Utilitron-Robotics/johnny5/software/README.md

This folder includes AlohaMini-specific patches and extensions for the LeRobot framework.

If you prefer a plug-and-play setup with all components already integrated,
please use the dedicated software repository:

👉 https://github.com/liyitenga/lerobot_alohamini
