Utilitron-Robotics/johnny5/hardware/arms/README.md

This arm design is based on Lekiwi (base) and SO100 (arm structure).
We merged and adapted the two projects for the AlohaMini platform.
Huge thanks to the original creators for their excellent work.

Original projects:

- Lekiwi: https://github.com/SIGRobotics-UIUC/LeKiwi

- SO100: https://github.com/TheRobotStudio/SO-ARM100
