Utilitron-Robotics/johnny5/docs/integration_review.md

# Integration Review: Johnny 5 + WhoAmI

## 1. Overview
We have successfully forked the original AlohaMini/LeKiwi codebase and transformed it into **Johnny 5**, a Tier-3 autonomous mobile manipulator. This review covers the integration of the "WhoAmI" intelligence stack (derived from `alanchelmickjr/whoami`) into the new Johnny 5 architecture.

## 2. The "WhoAmI" Intelligence Stack
We successfully recovered and ported the following core components from the "LetsConnect" repository:

### 🧠 Memory (Gun.js)
*   **Source**: `whoami/gun_storage.py` -> `johnny5/memory.py`
*   **Function**: Provides decentralized, encrypted, graph-based storage for the robot's experiences.
*   **Key Feature**: "Robot-owned data" philosophy. Faces and interactions are stored locally and encrypted, respecting user privacy while enabling long-term memory.

### 🗣️ Voice (PyTTSx3 + Vosk/Google)
*   **Source**: `whoami/voice_interaction.py` -> `johnny5/voice.py`
*   **Function**: Enables natural language interaction.
*   **Key Feature**: The `ask_name()` flow allows the robot to proactively build its social graph by asking strangers for their names and confirming them.

### 👁️ Vision (Face Recognition)
*   **Source**: `whoami/face_recognition_api.py` -> `johnny5/vision.py`
*   **Function**: Detects and identifies people.
*   **Key Feature**: Integrated with the Memory system to link visual embeddings with "Person" nodes in the Gun.js graph.

## 3. LeRobot Integration Strategy
The `Johnny5Robot` class (`software/src/johnny5/robot.py`) has been re-architected to serve as a **LeRobot-compatible Agent**.

*   **Observation Space**:
    *   `observation.images.camera_front`: RGB feed from OAK-D/RealSense.
    *   `observation.state`: Joint positions (arms) + Base velocity.
*   **Action Space**:
    *   `action`: 14-DOF vector (Arm Joints + Base Velocity + Lift).
*   **Policy Loop**:
    *   The `step()` method enables the robot to run LeRobot inference (ACT/Diffusion policies) while simultaneously maintaining a social presence via the "WhoAmI" background threads.

## 4. Next Steps
1.  **Hardware Drivers**: Implement the `DifferentialDrive` class for the specific off-the-shelf base chosen.
2.  **Policy Training**: Collect teleoperation data using the new rig to train a `johnny5-manipulation` policy.
3.  **ROS 2 Bridge**: (Optional) Wrap the Python `Johnny5Robot` class in a ROS 2 Node for easier integration with the Nav2 stack.
