Utilitron-Robotics/johnny5/docs/BOM.md

# Bill of Materials

AlohaMini follows the same architecture and terminology as LeKiwi, consisting of a Client side and a Host side.

- The Client handles computation and control.
- The Host executes commands and returns observations.

This is also commonly referred to as PC side vs. Remote side, and both naming conventions are equivalent.

AlohaMini’s Client hardware includes the mobile base and two follower arms. The arms directly reuse the SO-ARM100 design. Therefore, if you already have two SO-ARM100 arms, you only need to assemble the mobile base. Communication between the mobile base, arms, and Raspberry Pi 5 uses the same bus-servo communication system, and the build guide will explain the wiring in detail.

On AlohaMini, the Host side consists of a PC workstation and leader arms. VR controllers or other devices can also replace the leader arms, and we will release compatible controller kits soon. For beginners, we recommend starting with leader-arm teleoperation.

*Note: Table clamp, screwdriver set, soldering iron, and other common tools can be sourced as needed and are not listed in the tables below.*

## Mobile base 

| Item | Model / Notes | Qty | Unit Cost (US) | Buy (US) | Unit Cost (CN) | Buy (CN) |
|---|---|-----|---|---|---|---|
| Servo motor | Feetech STS3215 (12 V bus) | 4 | $13.89 | [Alibaba](https://www.alibaba.com/product-detail/6PCS-7-4V-STS3215-Servos-for_1600523509006.html) | ¥110 | [taobao](https://e.tb.cn/h.64H9u3maGWzIp5Q?tk=T5liexkG6Yz) |
| Omni wheel | 4″ (≈100 mm) | 3 | $47 | [Amazon](https://www.amazon.com/Replacement-Plastic-Directional-Accessories-Platform/dp/B0F9W6QX5M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) | ¥135 | [pinduoduo](https://mobile.yangkeduo.com/goods.html?ps=kKWPC7xuzw) |
| USB camera | 720p focal length 2.4 mm | 3 | — | Amazon | ¥125 | [taobao](https://item.taobao.com/item.htm?id=666278411821) |
| (optional) Bearing | 12×18×4 mm (ID × OD × W) — wheel axle bearing | 3 | — | Amazon | ¥6 | [tmall](https://detail.tmall.com/item.htm?id=824704356695) |
| Bearing | 4×13×5 mm (ID × OD × W) — lift axis bearing | 8 | — | Amazon | ¥3 | [taobao](https://item.taobao.com/item.htm?id=565418362178) |
| M2×12 Phillips screw | For camera mounts (OB_T_Camera_Mount.stl, OB_Top_Camera_Mount) | 12 | — | — | — | — |
| M3×12 hex socket screw | Total 36 pcs (Servo Mount×24 ,Side Panel×12 ) | 36 | — | — | — | — |
| M3×18 hex socket screw | For OB_Chassis_Wheel_Axle_Connector.stl | 12 | — | — | — | — |
| M3×30 hex socket screw | For OB_T_Connector_Right/Left.stl | 8 | — | — | — | — |
| M3 hex nut | For OB_T_Connector_Right/Left.stl | 8 | — | — | — | — |
| M3x5x4 heat-set insert | Total 36 pcs (Servo Mount×24, Side Panel×12) | 36 | — | Amazon | ¥5 | [taobao](https://item.taobao.com/item.htm?id=809241671998) |
| M4×12 hex socket screw | Total 20 pcs (Bearing Cover×12, Z-axis Servo Mount×8) | 20 | — | Amazon | — | — |
| M4x6x5 heat-set insert | For OB_Chassis_Bearing_Cover.stl | 12 | — | Amazon | ¥4 | [taobao](https://item.taobao.com/item.htm?id=809241671998) |
| Adhesive | Double-sided tape / epoxy — cable retention & structural bonding | 1 | — | Amazon | ¥12 | [jd](https://item.jd.com/100141557259.html) |
| Servo extension cable | SCS 3-pin, 90 cm | 2 | — | Amazon | ¥3 | [taobao](https://item.taobao.com/item.htm?id=616460581906) |
| Battery | 12V Li-ion pack with 5521 barrel jack (male & female) | 1 | $43 | [Amazon](https://www.amazon.com/KBT-Rechargeable-Connector-Replacement-Security/dp/B0C242DYT1/ref=sr_1_2_sspa?th=1) | ¥130 | [taobao](https://item.taobao.com/item.htm?id=890828103056) |
| USB Type-C cable | Only for testing the mobile base | 1 | $10 | [Amazon](https://www.amazon.com/Charging-etguuds-Charger-Braided-Compatible/dp/B0B8NWLLW2/?th=1) | ¥20 | [tmall](https://detail.tmall.com/item.htm?id=754024805047) |
| Waveshare Bus Servo Controller | Only for testing the mobile base | 1 | $13 | [Amazon](https://www.amazon.com/Waveshare-Integrates-Control-Circuit-Supports/dp/B0CTMM4LWK/) | ¥27 | [tmall](https://detail.tmall.com/item.htm?id=738817173460) |
| 3D-printed parts | PLA/PETG/ABS (files in /hardware/mobile_base/stl) | ~4 kg filament | — | — | — | — |

**3D Printing Parts List:**
- OB_Chassis_Bearing_Cover x3
- OB_Chassis_Servo_Mount x3
- OB_Chassis_Side_Panel x3
- OB_Chassis_Wheel_Axle_Connector x3
- OB_Chassis_Wheel_Guard x3
- All other files x1

### What the Base Can Do

With only the components above, you can assemble the **mobile base** and control:

- movement  
- vertical lift  

directly from your **PC**, without installing a single-board computer on the robot.

We will cover the specifics in the software setup section.

Effect after assembly:

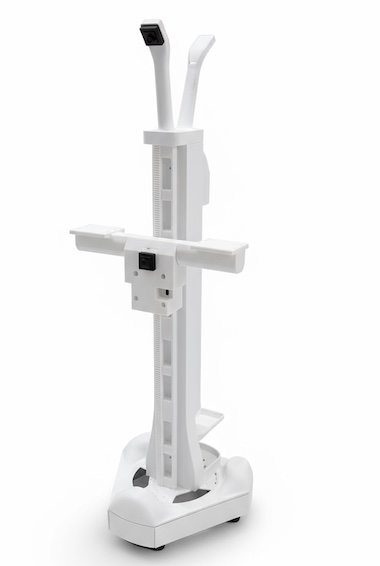
[picture p5: docs/media/assembled.jpg]
Assembled AlohaMini mobile base

### Standalone Mode (Optional)

If you prefer the base to operate as an **independent host system** (Wi‑Fi, untethered), add:

| Item | Model / Notes | Qty | Unit Cost (US) | Buy (US) | Unit Cost (CN) | Buy (CN) |
|---|---|-----|---|---|---|---|
| Compute board | Raspberry Pi 5 (4GB/8GB) | 1 | — | [Adafruit](https://www.adafruit.com/product/5812) | ¥600 | [taobao](https://item.taobao.com/item.htm?id=688878446695) |
| DC converter | 12V → 5V / 5A buck converter | 1 | $13 | [Amazon](https://www.amazon.com/Klnuoxj-Converter-Interface-Waterproof-Compatible/dp/B0CRVW7N2J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) | ¥64 | [taobao](https://item.taobao.com/item.htm?id=800698078303) |
| Monitor | 7-inch HD IPS HDMI interface + touch + Type C power supply | 1 | — | Amazon | ¥291 | [taobao](https://item.taobao.com/item.htm?id=592070943040) |

## Follower Arms
| Item | Model / Notes | Qty | Unit Cost (US) | Buy (US) | Unit Cost (CN) | Buy (CN) |
|---|---|-----|---|---|---|---|
| Servo motor | Feetech STS3215 (12V bus) | 12 | $13.89 | [Alibaba](https://www.alibaba.com/product-detail/Feetech-STS3215-SO-ARM100-Servo-12V_1601292634404.html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) | ¥110 | [taobao](https://e.tb.cn/h.64H9u3maGWzIp5Q?tk=T5liexkG6Yz) |
| Waveshare Bus Servo Controller | For connecting to the Raspberry Pi 5 | 2 | $13 | [Amazon](amazon.com/Waveshare-Integrates-Control-Circuit-Supports/dp/B0CTMM4LWK/) | ¥27 | [tmall](https://detail.tmall.com/item.htm?id=738817173460) |
| USB camera | 720p focal length 3.8 mm | 2 | — | Amazon | ¥103 | [taobao](https://item.taobao.com/item.htm?id=590682120464) |
| Battery | 12V Li-ion pack | 1 | — | [Amazon](https://www.amazon.com/KBT-Rechargeable-Connector-Replacement-Security/dp/B0C242DYT1/ref=sr_1_2_sspa?th=1) | ¥130 | [taobao](https://item.taobao.com/item.htm?id=890828103056) |
| 1-to-2 DC splitter cable | 30 cm, 5521 connector — for powering the arms | 1 | — | Amazon | ¥5 | [taobao](https://item.taobao.com/item.htm?id=594921965049) |
| DC extension cable | 1.5 m, 5521 connector — for powering the arms | 2 | — | Amazon | ¥2.50 | [taobao](https://item.taobao.com/item.htm?id=43628177900) |
| USB Type-C cable | For connecting to the Raspberry Pi 5 | 2 | $10 | [Amazon](https://www.amazon.com/Charging-etguuds-Charger-Braided-Compatible/dp/B0B8NWLLW2/?th=1) | ¥20 | [tmall](https://detail.tmall.com/item.htm?id=754024805047) |
| 3D-printed parts | PLA/PETG/ABS (files in /hardware/arms/stl) | 1 set | — | — | — | — |

**3D Printing Parts List:**
- All "D_*.stl" files: x2
- All "F_*.stl" files: x2

For detailed printing instructions, refer to the [SO-ARM100 project README](https://github.com/TheRobotStudio/SO-ARM100)

## Leader Arms
> **Note:** The official SO-ARM100 design uses three different gear ratios (1/147, 1/191, 1/345) for optimal performance. However, our testing shows that using a single gear ratio (1/147) provides excellent user experience and significantly simplifies assembly. The BOM below reflects this simplified configuration.

| Item | Model / Notes | Qty | Unit Cost (US) | Buy (US) | Unit Cost (CN) | Buy (CN) |
|---|---|-----|---|---|---|---|
| Servo motor | Feetech STS3215 (7.4V bus, 147:1 gear ratio) | 12 | $13.89 | [Alibaba](https://www.alibaba.com/product-detail/Standard-Open-SO-100-SO-101_1601503860487.html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) | ¥99 | [taobao](https://item.taobao.com/item.htm?id=616159163206) |
| Waveshare Bus Servo Controller | For connecting to the PC | 2 | $13 | [Amazon](https://www.amazon.com/Waveshare-Integrates-Control-Circuit-Supports/dp/B0CTMM4LWK/) | ¥27 | [tmall](https://detail.tmall.com/item.htm?id=738817173460) |
| Battery | 5V Li-ion pack | 1 | — | Amazon | ¥30 | [taobao](https://item.taobao.com/item.htm?id=765749120668) |
| 1-to-2 DC splitter cable | 70 cm — for powering the arms | 1 | — | Amazon | ¥5 | [taobao](https://item.taobao.com/item.htm?id=594921965049) |
| USB Type-C cable | For connecting to the PC | 2 | $10 | [Amazon](https://www.amazon.com/Charging-etguuds-Charger-Braided-Compatible/dp/B0B8NWLLW2/?th=1) | ¥20 | [tmall](https://detail.tmall.com/item.htm?id=754024805047) |
| 3D-printed parts | PLA/PETG/ABS (files in /hardware/arms/stl) | 1 set | — | — | — | — |

**3D Printing Parts List:**
- All "D_*.stl" files: x2
- All "L_*.stl" files: x2

For detailed printing instructions, refer to the [SO-ARM100 project README](https://github.com/TheRobotStudio/SO-ARM100)
