Utilitron-Robotics/johnny5/hardware/alohamini_base/stl/O_Main_Assembly_Post1.stl

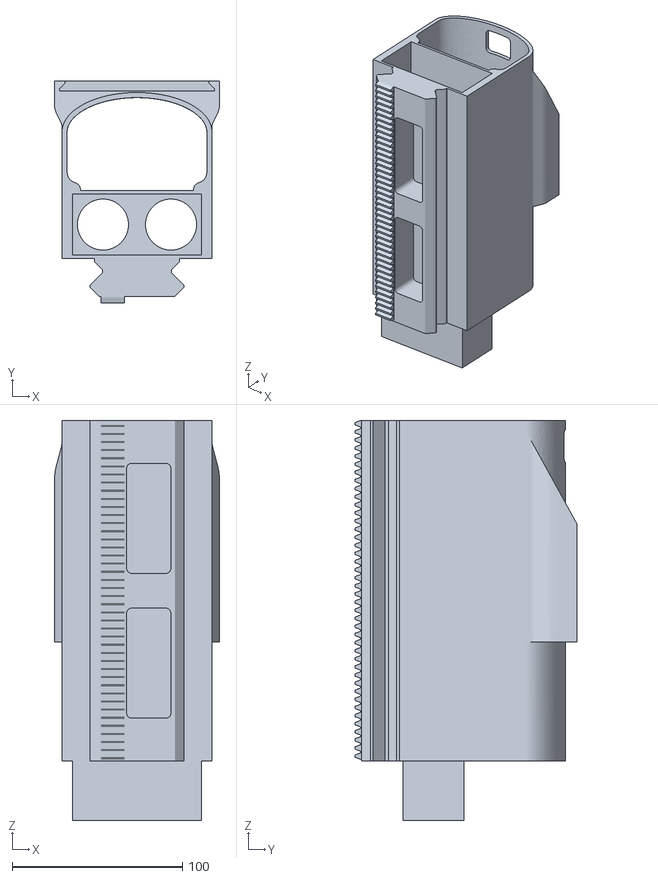
[picture p6: CAD file, 2025-11-22]
hardware/alohamini_base/stl/O_Main_Assembly_Post1.stl
97.0 x 130.7 x 235.0
