Utilitron-Robotics/johnny5/hardware/alohamini_base/stl/O_Main_Assembly_Post3.stl

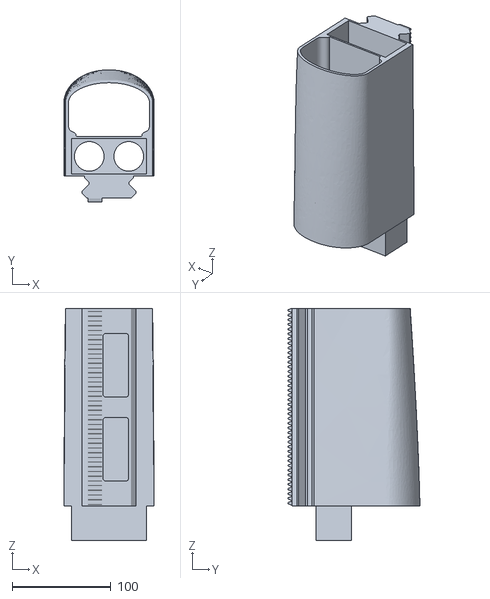
[picture p7: CAD file, 2025-11-22]
hardware/alohamini_base/stl/O_Main_Assembly_Post3.stl
91.5 x 133.6 x 235.0
