Utilitron-Robotics/johnny5/hardware/alohamini_base/stl/O_Main_Assembly_Post2.stl

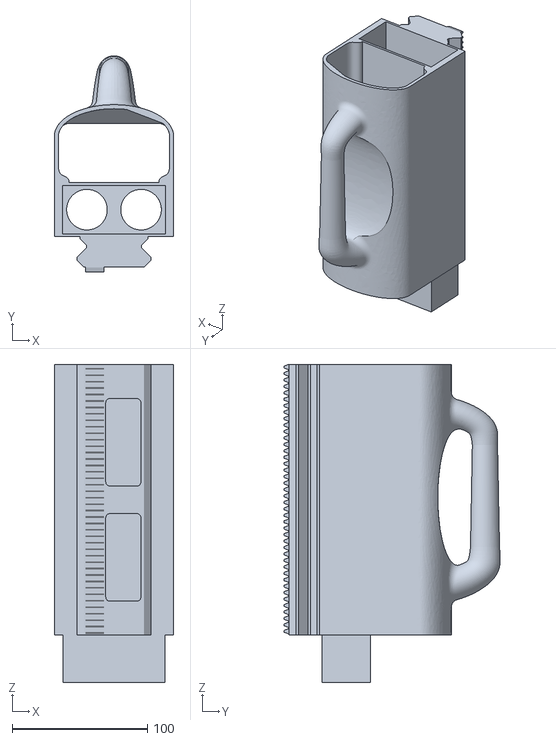
[picture p8: CAD file, 2025-11-22]
hardware/alohamini_base/stl/O_Main_Assembly_Post2.stl
88.1 x 159.9 x 235.0
