Utilitron-Robotics/johnny5/hardware/alohamini_base/stl/OB_Main_Monitor_Connector.stl

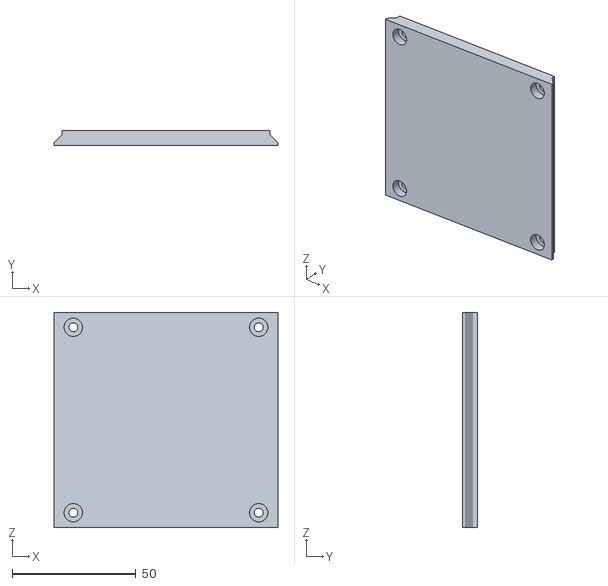
[picture p9: CAD file, 2025-11-22]
hardware/alohamini_base/stl/OB_Main_Monitor_Connector.stl
90.6 x 6.00 x 87.0
