Utilitron-Robotics/johnny5/hardware/alohamini_base/stl/OB_Top_Camera_Back_Cover.stl

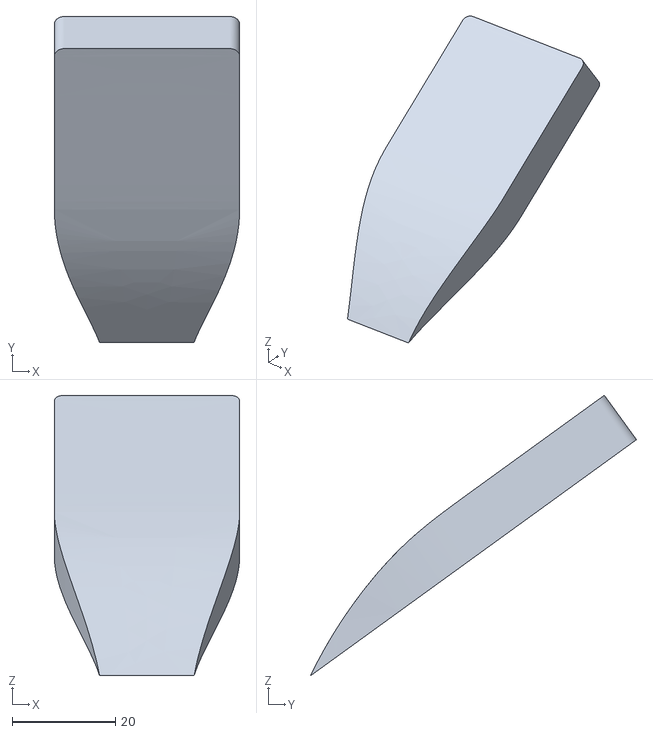
[picture p10: CAD file, 2025-11-22]
hardware/alohamini_base/stl/OB_Top_Camera_Back_Cover.stl
35.9 x 63.2 x 54.4
