Utilitron-Robotics/johnny5/hardware/alohamini_base/stl/Optional/OB_Chassis_Shaft_Sleeve_12_24.stl

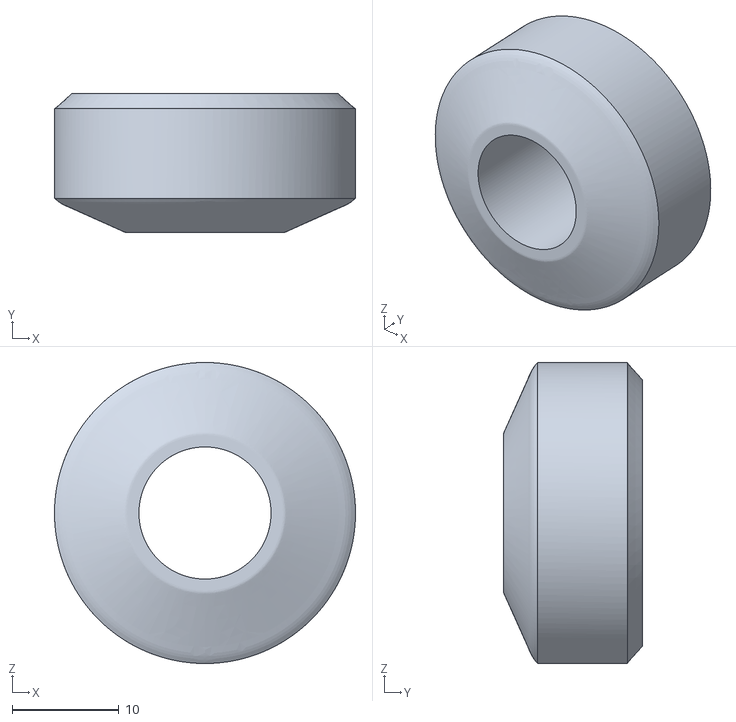
[picture p11: CAD file, 2025-11-22]
hardware/alohamini_base/stl/Optional/OB_Chassis_Shaft_Sleeve_12_24.stl
28.1 x 13.0 x 28.1
