Utilitron-Robotics/johnny5/hardware/arms/stl/D_Motor_holder_SO101_Wrist.stl

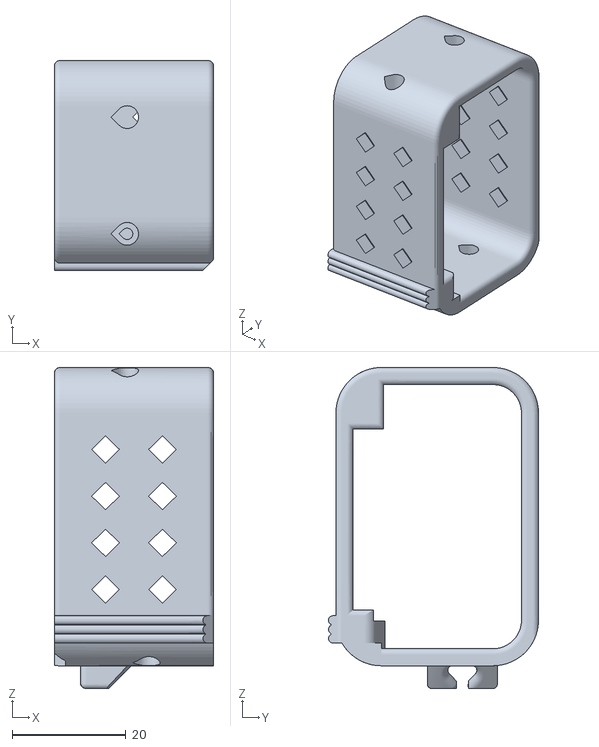
[picture p12: CAD file, 2025-11-22]
hardware/arms/stl/D_Motor_holder_SO101_Wrist.stl
28.0 x 36.9 x 56.4
