Utilitron-Robotics/johnny5/hardware/alohamini_base/stl/O_Chassis_Lower_Plate.stl

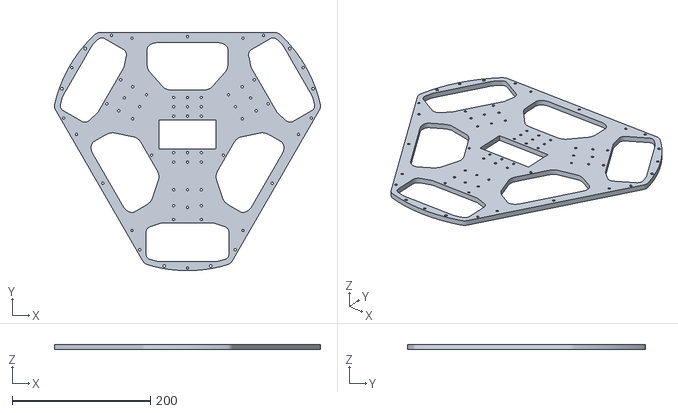
[picture p13: CAD file, 2025-11-22]
hardware/alohamini_base/stl/O_Chassis_Lower_Plate.stl
384.5 x 344.4 x 7.00
