Utilitron-Robotics/johnny5/hardware/alohamini_base/stl/Optional/O_Chassis_Dowel_Pin_12_24.stl

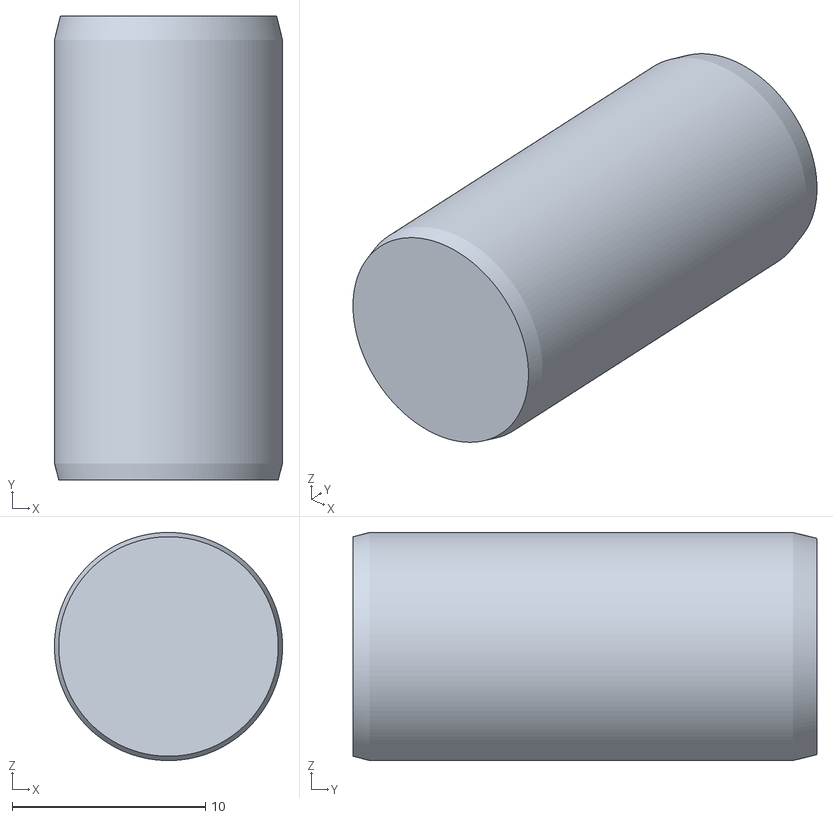
[picture p14: CAD file, 2025-11-22]
hardware/alohamini_base/stl/Optional/O_Chassis_Dowel_Pin_12_24.stl
11.8 x 24.0 x 11.8
