Utilitron-Robotics/johnny5/hardware/arms/stl/D_Seeedstudio_Mounting_Plate_SO101.stl

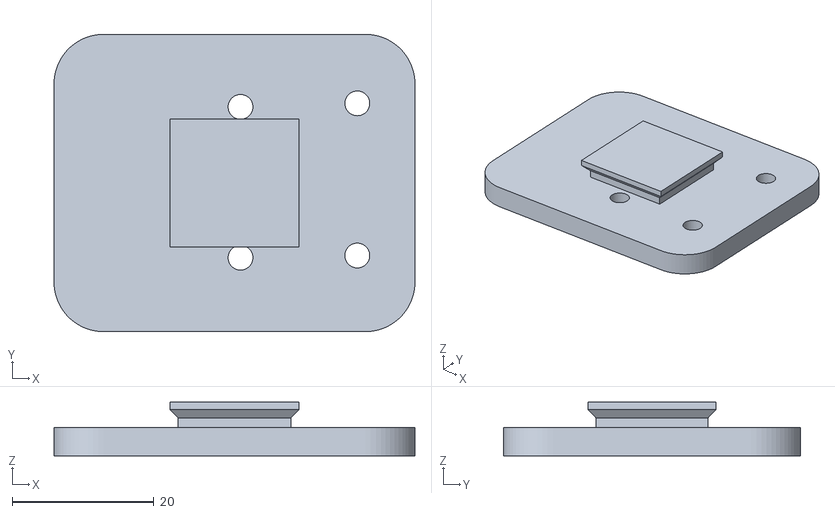
[picture p15: CAD file, 2025-11-22]
hardware/arms/stl/D_Seeedstudio_Mounting_Plate_SO101.stl
51.0 x 42.0 x 7.60
