Utilitron-Robotics/johnny5/hardware/alohamini_base/stl/OB_Chassis_Side_Panel.stl

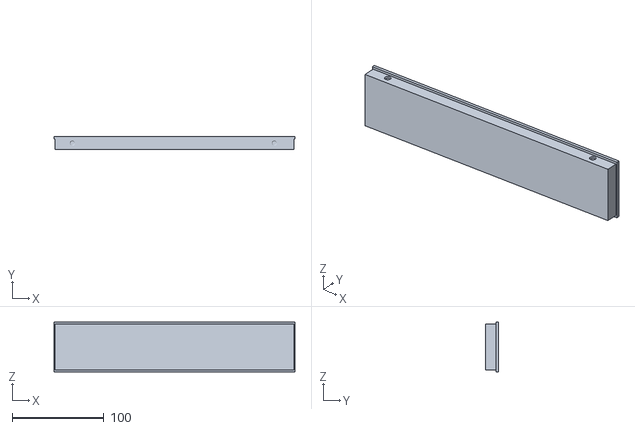
[picture p16: CAD file, 2025-11-22]
hardware/alohamini_base/stl/OB_Chassis_Side_Panel.stl
262.2 x 14.0 x 54.2
