Utilitron-Robotics/johnny5/hardware/arms/stl/D_Rotation_Pitch_SO101.stl

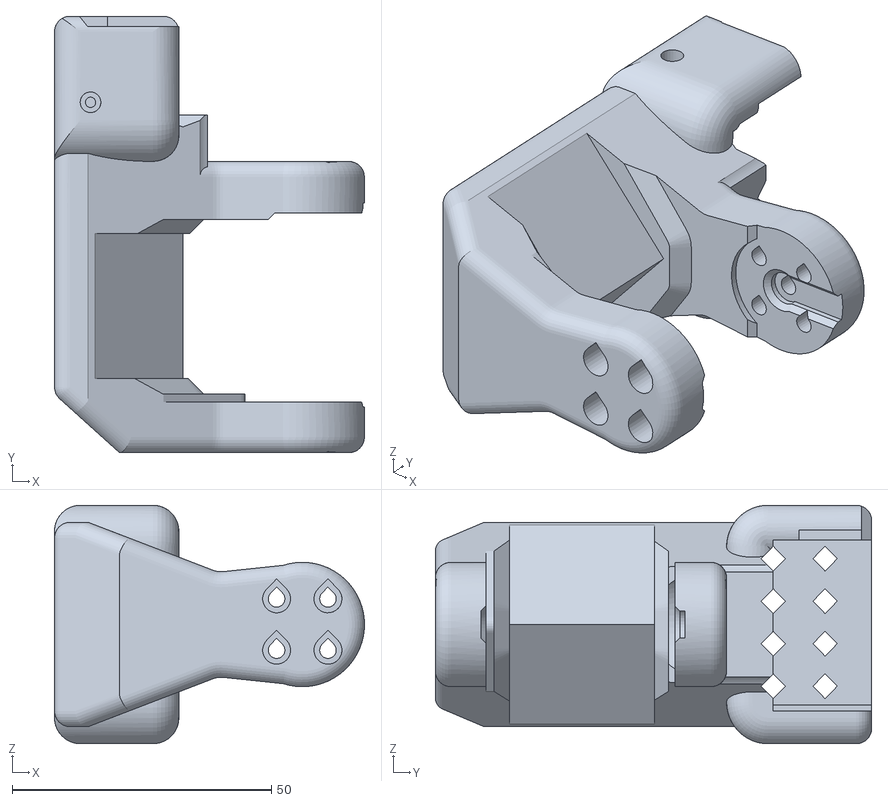
[picture p17: CAD file, 2025-11-22]
hardware/arms/stl/D_Rotation_Pitch_SO101.stl
59.8 x 84.2 x 46.0
