Utilitron-Robotics/johnny5/hardware/alohamini_base/stl/OB_Z_Axis_Servo_Mount.stl

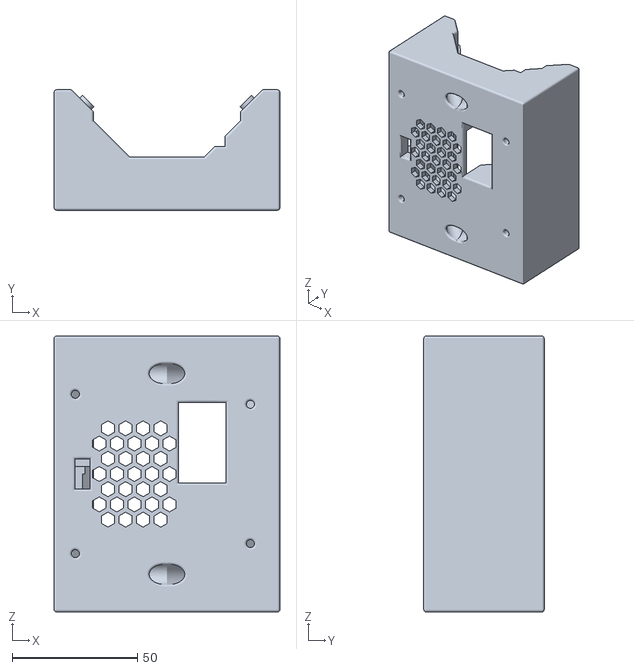
[picture p18: CAD file, 2025-11-22]
hardware/alohamini_base/stl/OB_Z_Axis_Servo_Mount.stl
90.0 x 48.0 x 110.0
