Utilitron-Robotics/johnny5/hardware/arms/stl/D_Under_arm_SO101.stl

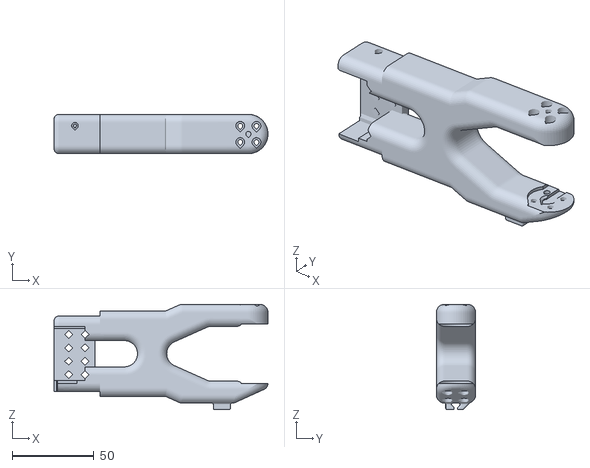
[picture p20: CAD file, 2025-11-22]
hardware/arms/stl/D_Under_arm_SO101.stl
130.7 x 24.0 x 64.4
