Utilitron-Robotics/johnny5/hardware/arms/stl/D_Base_SO101_Lekiwi.stl

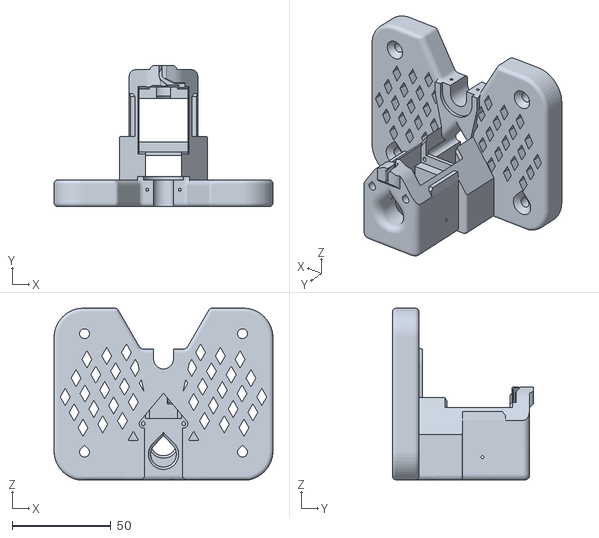
[picture p21: CAD file, 2025-11-22]
hardware/arms/stl/D_Base_SO101_Lekiwi.stl
110.9 x 71.6 x 87.0
