Utilitron-Robotics/johnny5/hardware/alohamini_base/stl/OB_T_Connector_Middle.stl

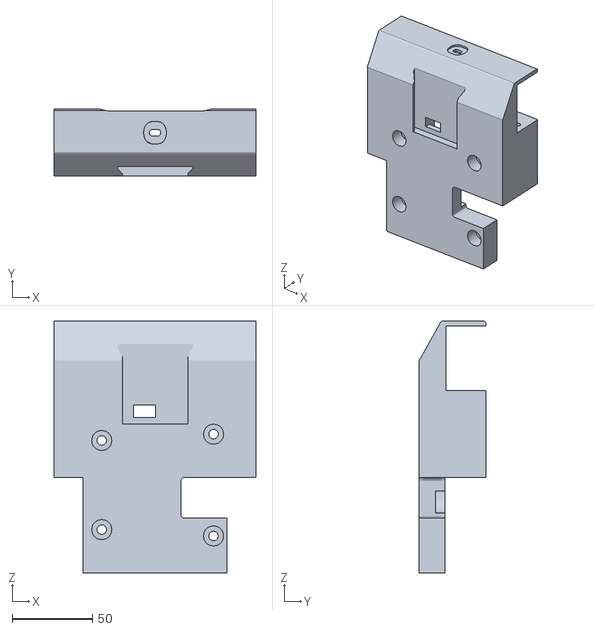
[picture p22: CAD file, 2025-11-22]
hardware/alohamini_base/stl/OB_T_Connector_Middle.stl
126.0 x 41.6 x 157.2
