Utilitron-Robotics/johnny5/hardware/arms/stl/L_Leader_Handle_SO101.stl

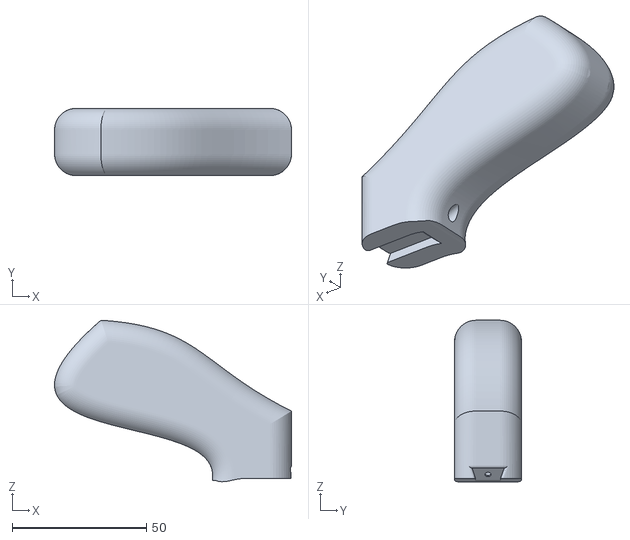
[picture p23: CAD file, 2025-11-22]
hardware/arms/stl/L_Leader_Handle_SO101.stl
88.1 x 25.0 x 60.1
