Utilitron-Robotics/johnny5/hardware/alohamini_base/stl/OB_T_Connector_Right.stl

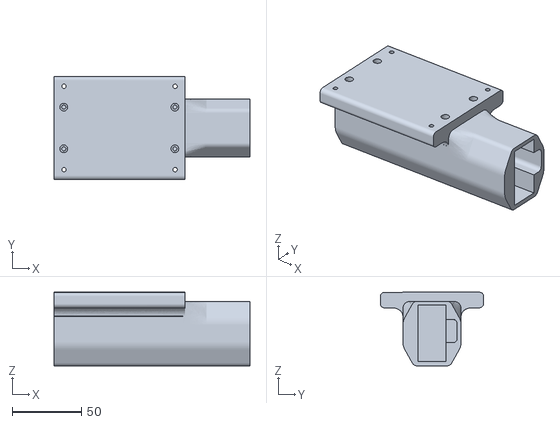
[picture p24: CAD file, 2025-11-22]
hardware/alohamini_base/stl/OB_T_Connector_Right.stl
141.1 x 74.4 x 53.1
