Utilitron-Robotics/johnny5/hardware/arms/stl/D_Wrist_Roll_Pitch_SO101.stl

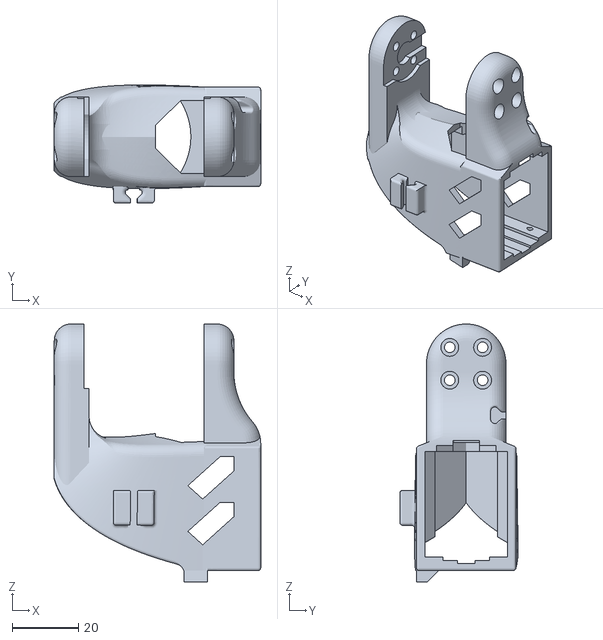
[picture p25: CAD file, 2025-11-22]
hardware/arms/stl/D_Wrist_Roll_Pitch_SO101.stl
62.3 x 35.7 x 77.8
