Utilitron-Robotics/johnny5/hardware/arms/stl/L_Leader_Trigger_SO101.stl

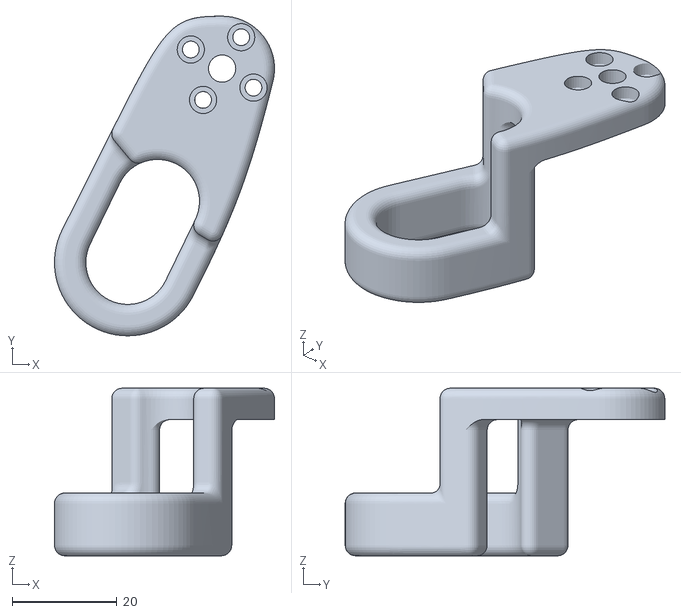
[picture p26: CAD file, 2025-11-22]
hardware/arms/stl/L_Leader_Trigger_SO101.stl
42.0 x 61.0 x 32.0
