Utilitron-Robotics/johnny5/hardware/alohamini_base/stl/OB_Chassis_Bearing_Cover.stl

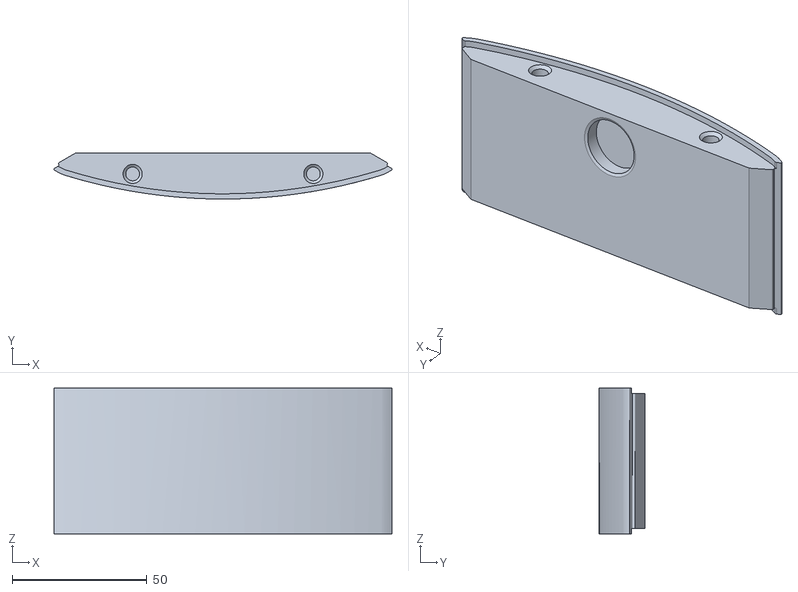
[picture p27: CAD file, 2025-11-22]
hardware/alohamini_base/stl/OB_Chassis_Bearing_Cover.stl
125.5 x 17.1 x 54.2
