Utilitron-Robotics/johnny5/hardware/arms/stl/D_Motor_holder_SO101_Base.stl

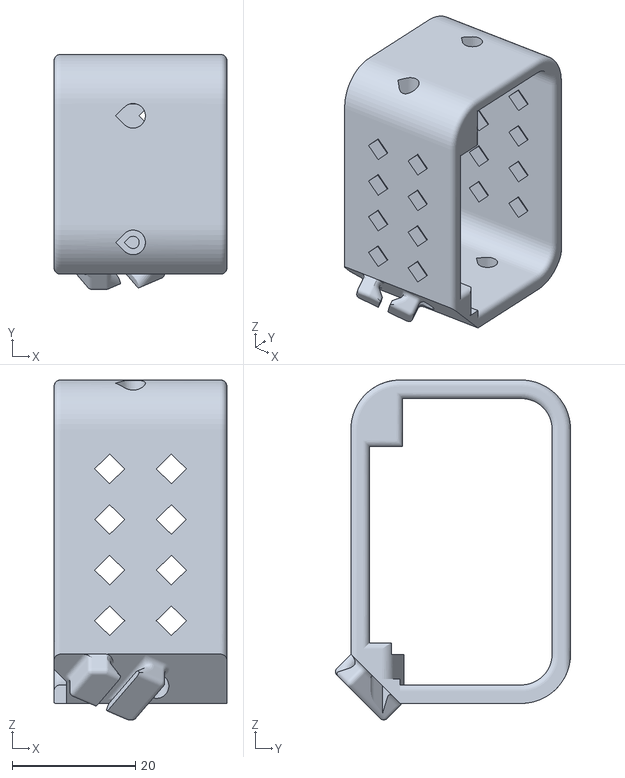
[picture p28: CAD file, 2025-11-22]
hardware/arms/stl/D_Motor_holder_SO101_Base.stl
28.0 x 38.1 x 55.1
