Utilitron-Robotics/johnny5/hardware/alohamini_base/stl/OB_T_Camera_Mount.stl

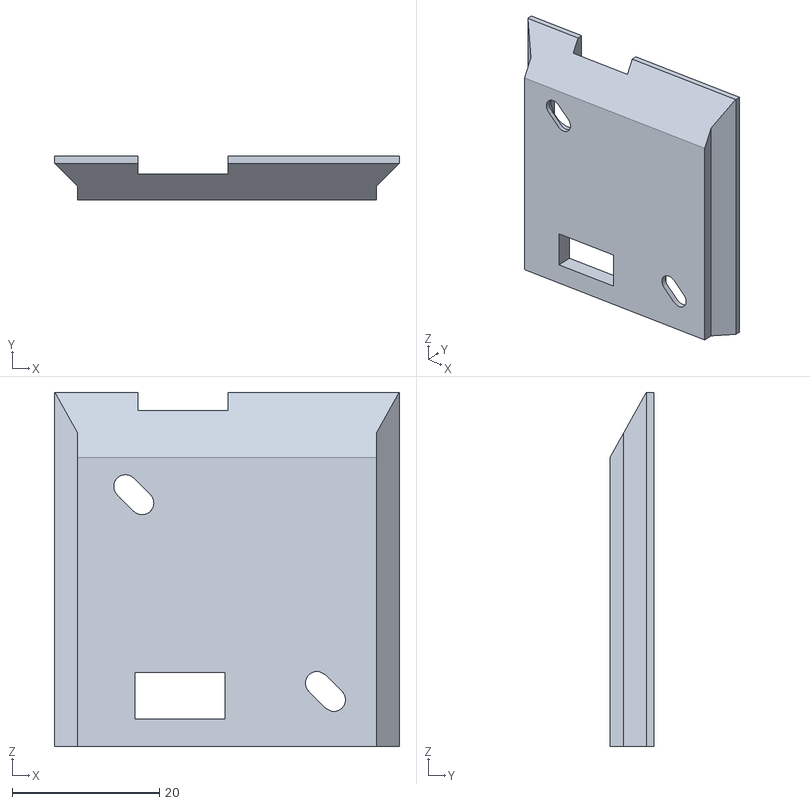
[picture p29: CAD file, 2025-11-22]
hardware/alohamini_base/stl/OB_T_Camera_Mount.stl
46.9 x 6.00 x 48.2
