Utilitron-Robotics/johnny5/hardware/arms/stl/F_Follower_Wrist_Roll_Follower_SO101.stl

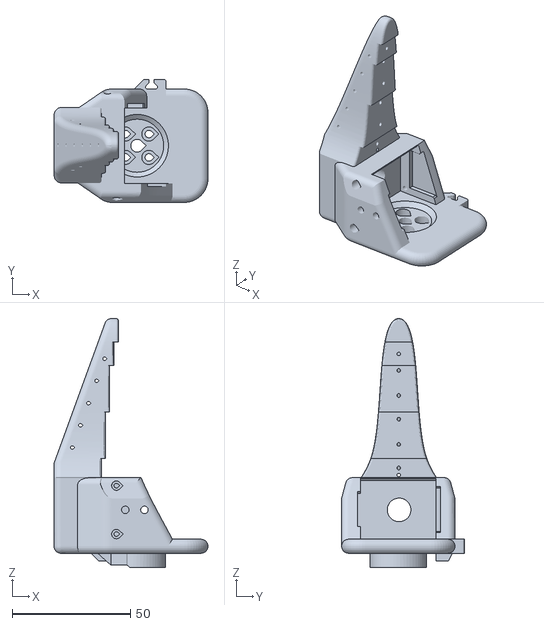
[picture p30: CAD file, 2025-11-22]
hardware/arms/stl/F_Follower_Wrist_Roll_Follower_SO101.stl
65.2 x 52.0 x 105.4
