Utilitron-Robotics/johnny5/hardware/arms/stl/D_Base_motor_holder_SO101.stl

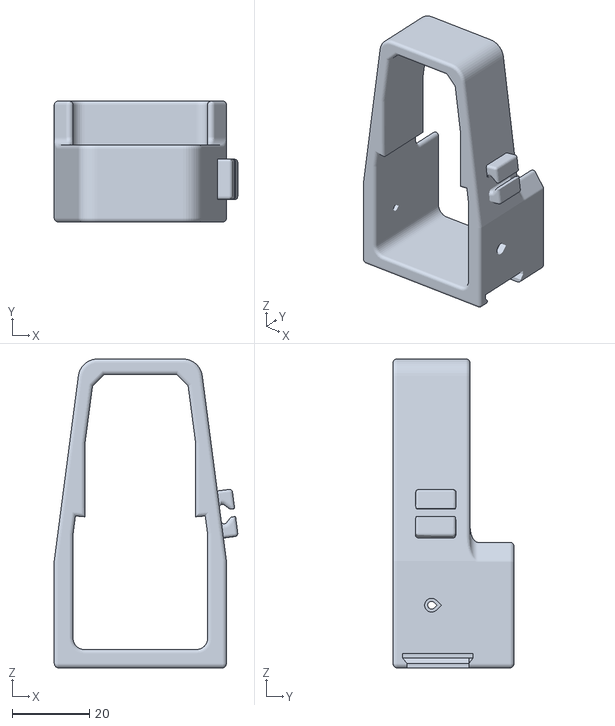
[picture p31: CAD file, 2025-11-22]
hardware/arms/stl/D_Base_motor_holder_SO101.stl
47.6 x 31.4 x 80.2
