Utilitron-Robotics/johnny5/hardware/alohamini_base/stl/OB_Chassis_Wheel_Axle_Connector.stl

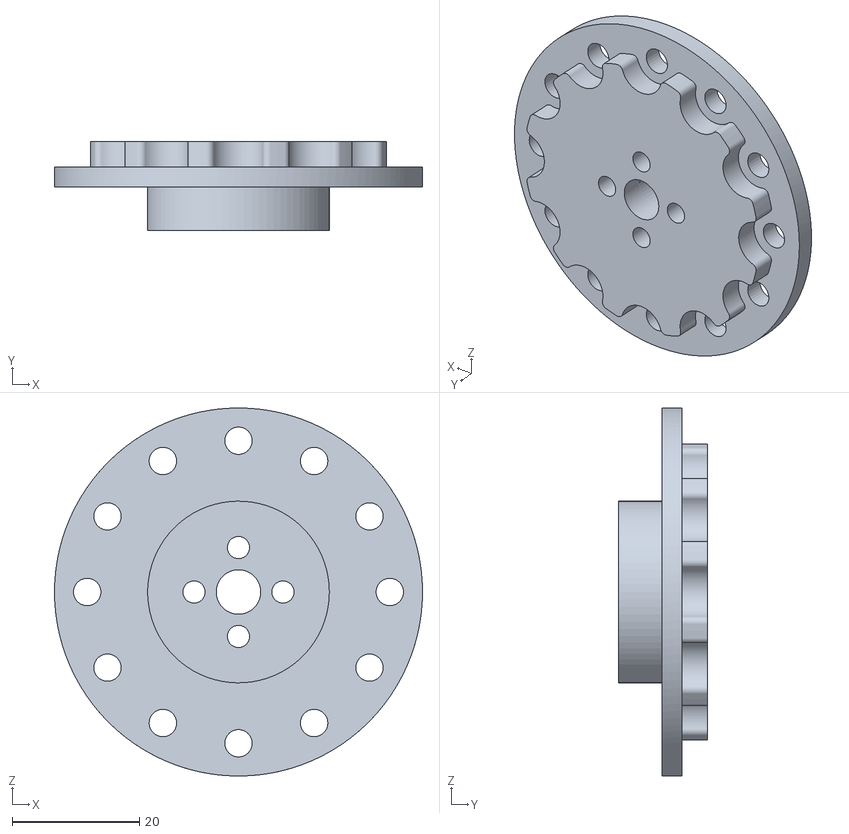
[picture p32: CAD file, 2025-11-22]
hardware/alohamini_base/stl/OB_Chassis_Wheel_Axle_Connector.stl
57.9 x 14.0 x 57.9
