Utilitron-Robotics/johnny5/hardware/arms/stl/D_Wrist_Roll_SO101.stl

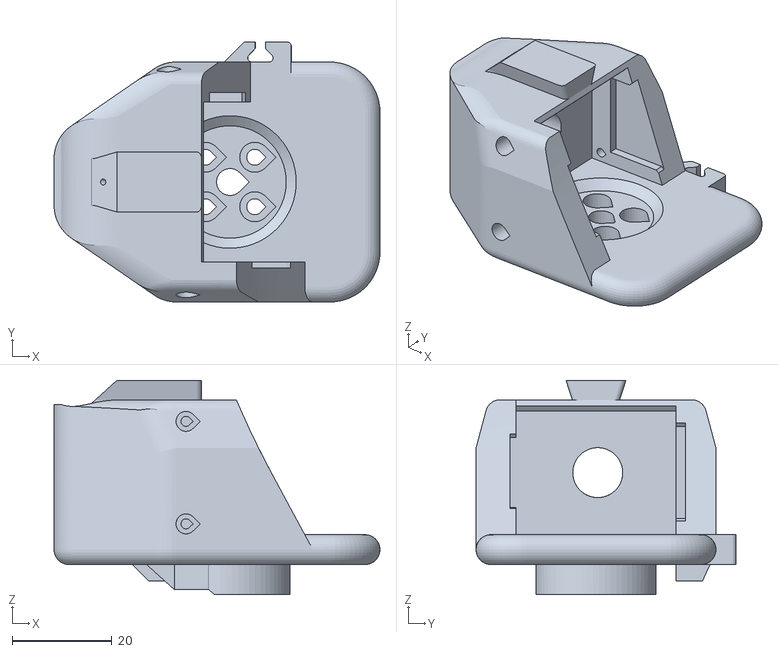
[picture p33: CAD file, 2025-11-22]
hardware/arms/stl/D_Wrist_Roll_SO101.stl
65.2 x 52.0 x 42.8
