Utilitron-Robotics/johnny5/hardware/alohamini_base/stl/OB_Chassis_Servo_Mount.stl

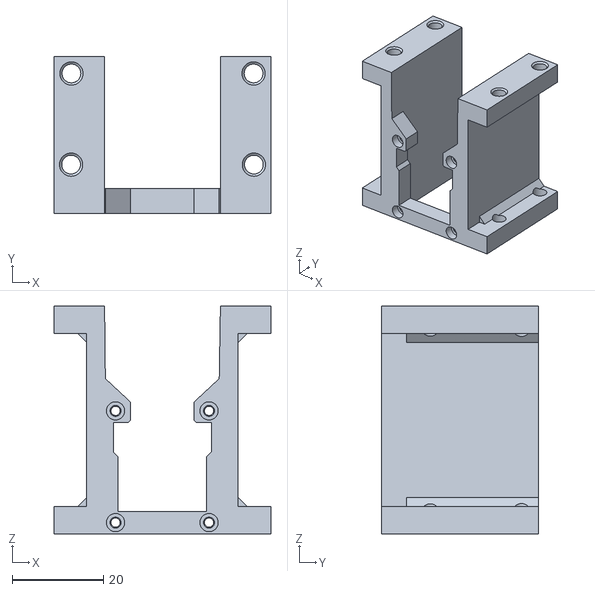
[picture p34: CAD file, 2025-11-22]
hardware/alohamini_base/stl/OB_Chassis_Servo_Mount.stl
47.6 x 34.5 x 50.0
