Utilitron-Robotics/johnny5/hardware/arms/stl/D_Upper_arm_SO101.stl

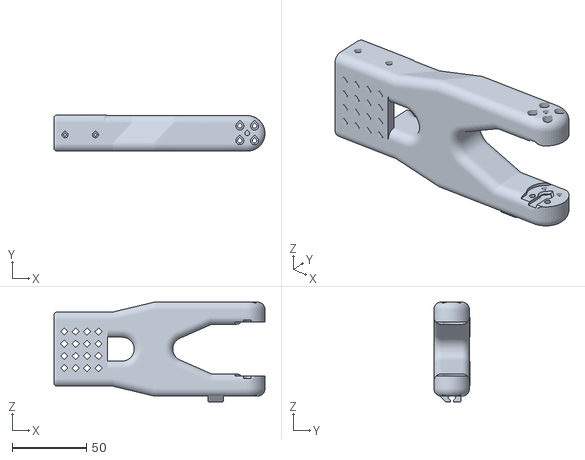
[picture p35: CAD file, 2025-11-22]
hardware/arms/stl/D_Upper_arm_SO101.stl
142.1 x 24.5 x 67.3
