Utilitron-Robotics/johnny5/hardware/alohamini_base/stl/O_Chassis_Upper_Plate.stl

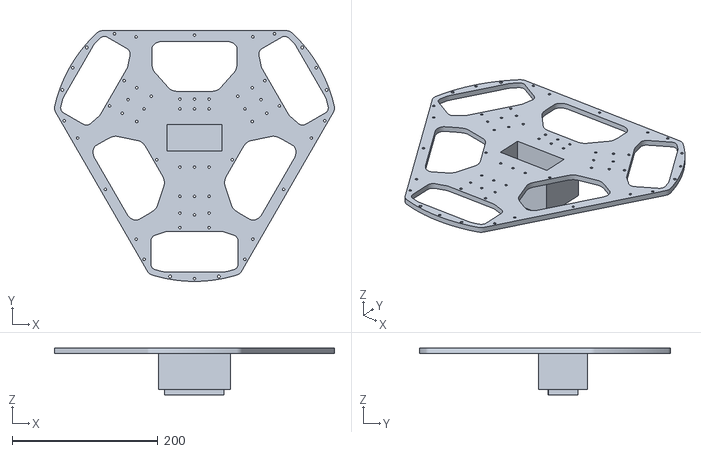
[picture p36: CAD file, 2025-11-22]
hardware/alohamini_base/stl/O_Chassis_Upper_Plate.stl
384.5 x 344.4 x 64.0
