Utilitron-Robotics/johnny5/hardware/arms/stl/F_Follower_Moving_Jaw_SO101.stl

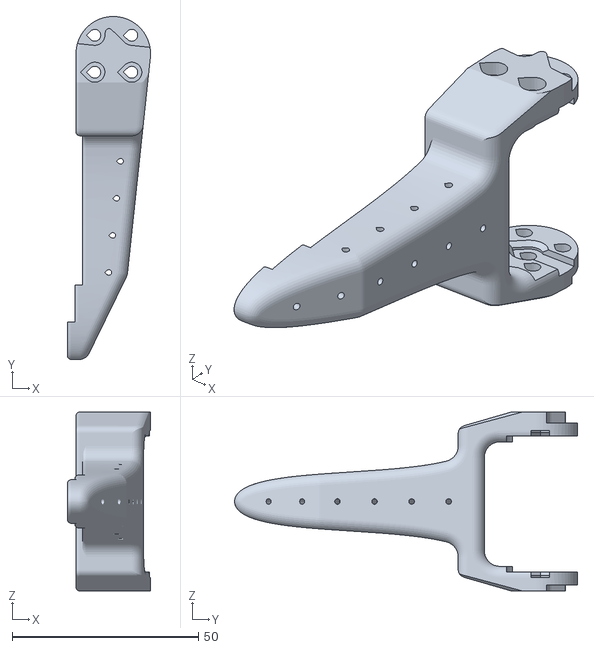
[picture p37: CAD file, 2025-11-22]
hardware/arms/stl/F_Follower_Moving_Jaw_SO101.stl
22.3 x 92.0 x 48.0
