Utilitron-Robotics/johnny5/hardware/alohamini_base/stl/OB_Z_Axis_Bracket.stl

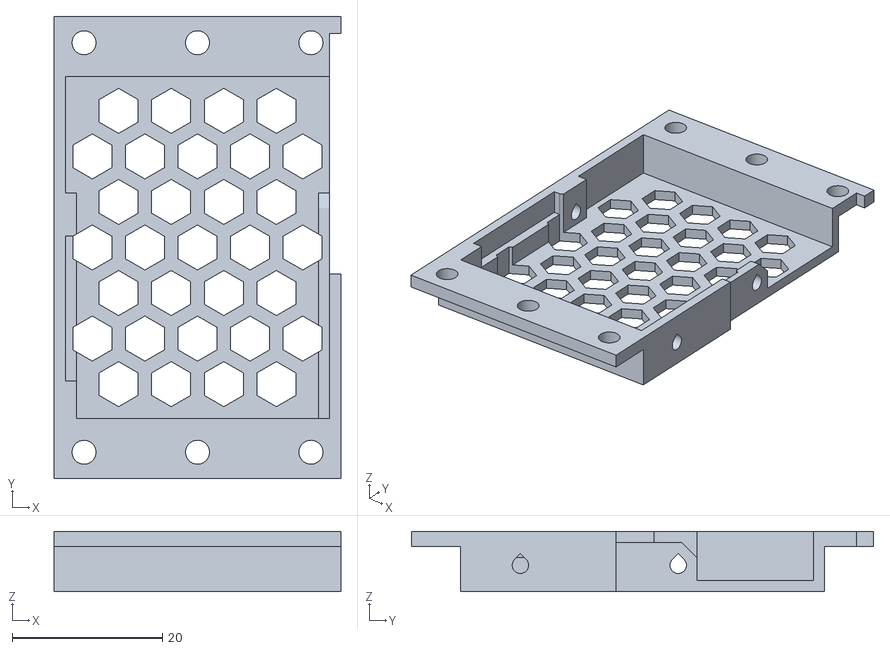
[picture p38: CAD file, 2025-11-22]
hardware/alohamini_base/stl/OB_Z_Axis_Bracket.stl
38.2 x 61.5 x 8.00
