Utilitron-Robotics/johnny5/hardware/arms/stl/F_Follower_SO-ARM101_camera_wrist_mount.stl

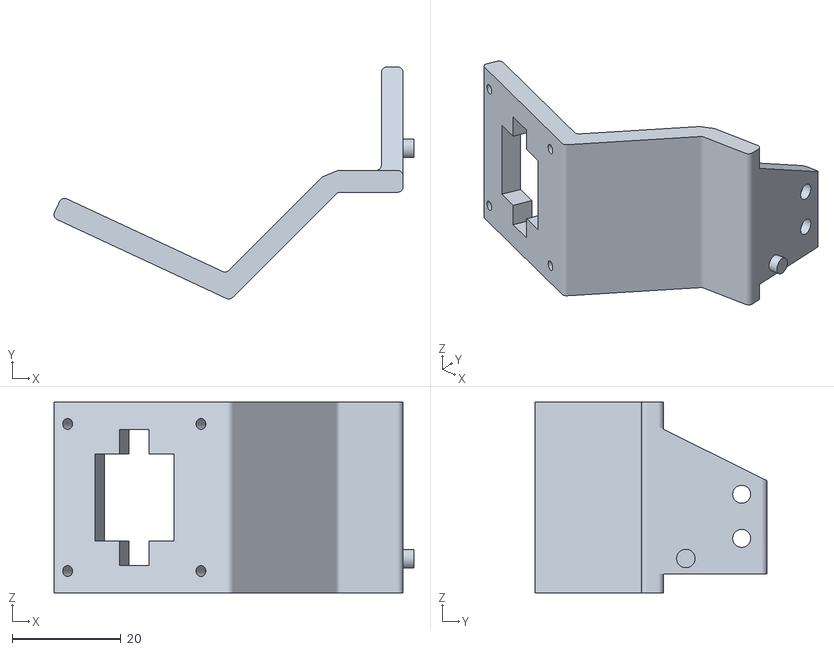
[picture p39: CAD file, 2025-11-22]
hardware/arms/stl/F_Follower_SO-ARM101_camera_wrist_mount.stl
66.1 x 42.6 x 35.0
