Utilitron-Robotics/johnny5/hardware/alohamini_base/stl/O_T_Connector_Cross_Bar.stl

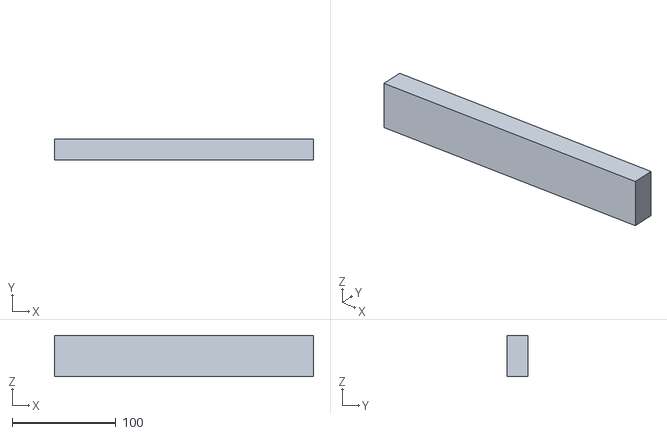
[picture p40: CAD file, 2025-11-22]
hardware/alohamini_base/stl/O_T_Connector_Cross_Bar.stl
250.0 x 20.0 x 40.0
