Utilitron-Robotics/johnny5/hardware/alohamini_base/stl/OB_Z_Axis_Servo_Gear.stl

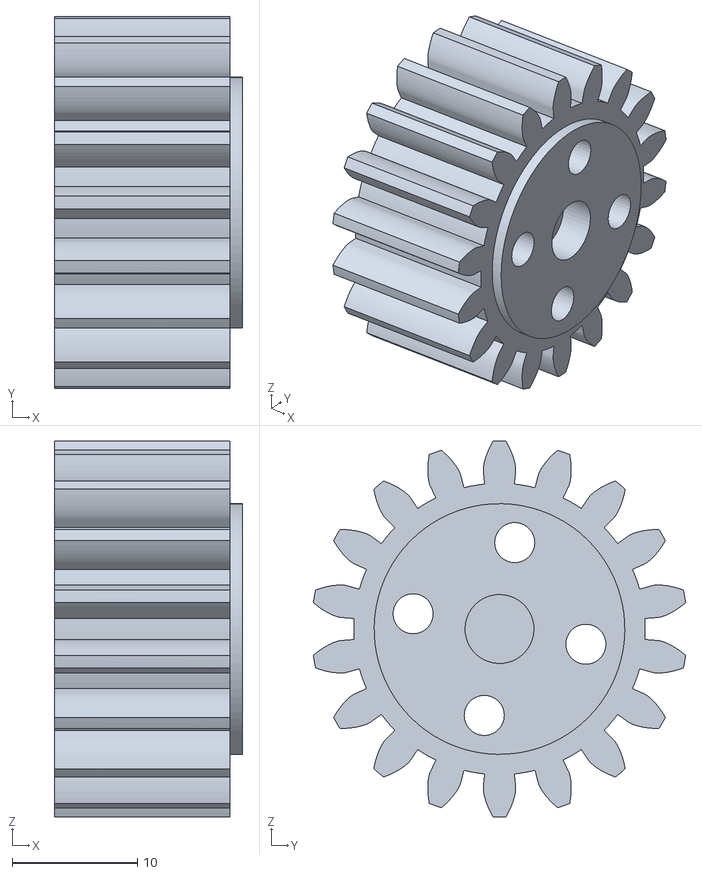
[picture p41: CAD file, 2025-11-22]
hardware/alohamini_base/stl/OB_Z_Axis_Servo_Gear.stl
15.0 x 29.7 x 30.0
