Utilitron-Robotics/johnny5/(list of files, cad)

Other CAD files:
hardware/alohamini_base/stl/OB_T_Connector_Left.stl
