Utilitron-Robotics/johnny5/docs/media/assembly/3.jpg

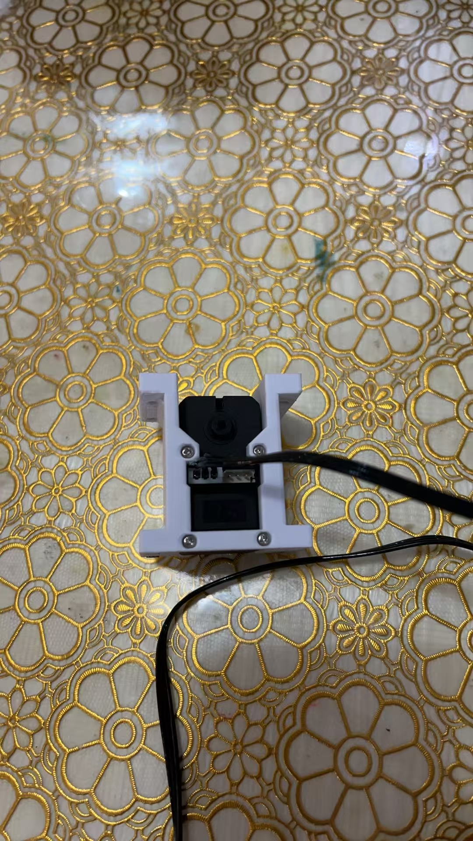
docs/media/assembly/3.jpg
