Utilitron-Robotics/johnny5/docs/media/assembly/7.jpg

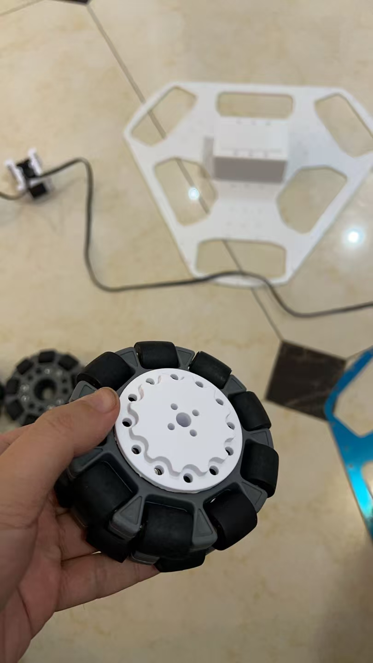
docs/media/assembly/7.jpg
