Utilitron-Robotics/johnny5/docs/media/assembly/23.jpg

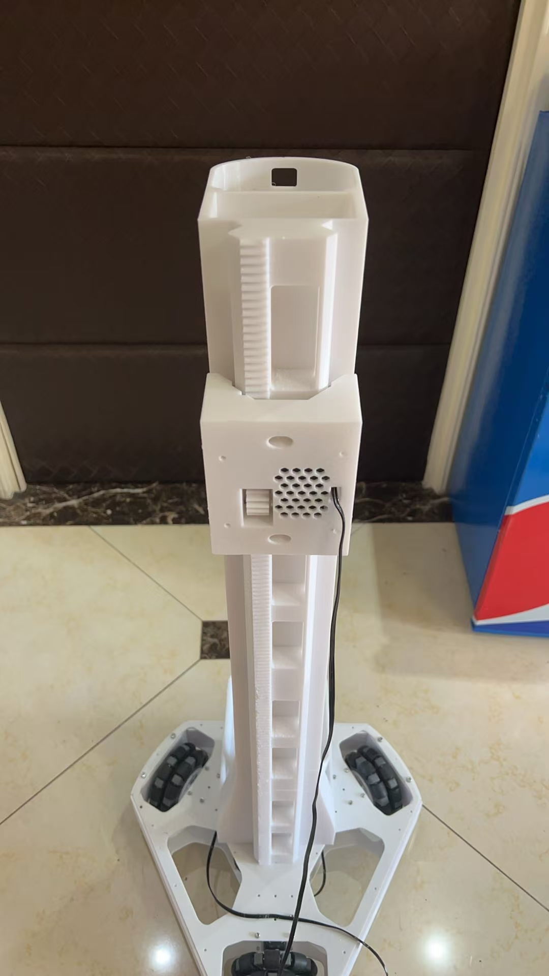
docs/media/assembly/23.jpg
