Utilitron-Robotics/johnny5/docs/media/assembly/36.jpg

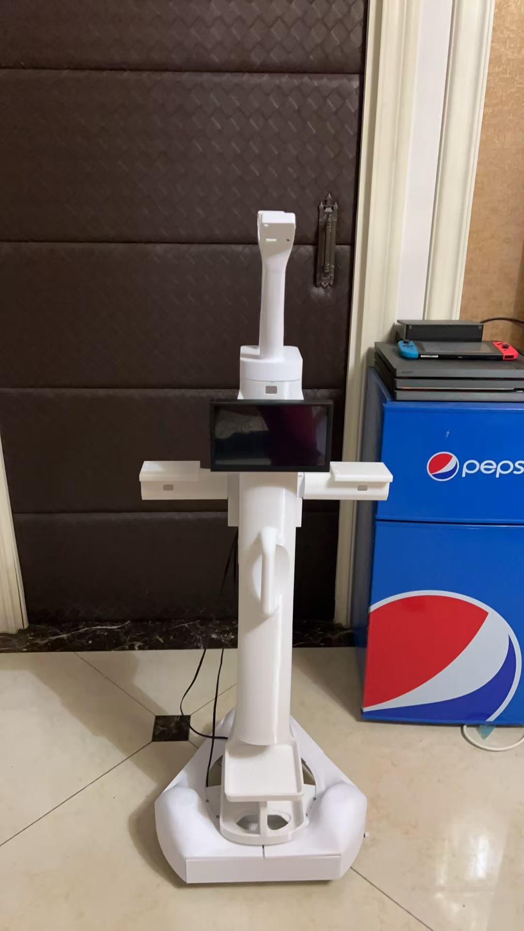
docs/media/assembly/36.jpg
