Utilitron-Robotics/johnny5/software/src/lerobot/robots/alohamini/lekiwi_client.py

# Copyright 2024 The HuggingFace Inc. team. All rights reserved.
#
# Licensed under the Apache License, Version 2.0 (the "License");
# you may not use this file except in compliance with the License.
# You may obtain a copy of the License at
#
#     http://www.apache.org/licenses/LICENSE-2.0
#
# Unless required by applicable law or agreed to in writing, software
# distributed under the License is distributed on an "AS IS" BASIS,
# WITHOUT WARRANTIES OR CONDITIONS OF ANY KIND, either express or implied.
# See the License for the specific language governing permissions and
# limitations under the License.

# TODO(aliberts, Steven, Pepijn): use gRPC calls instead of zmq?

import base64
import inspect
import json
import logging
from functools import cached_property
import os
from typing import Any

import cv2
import numpy as np

from lerobot.utils.errors import DeviceAlreadyConnectedError, DeviceNotConnectedError

from ..robot import Robot
from .config_lekiwi import LeKiwiClientConfig
from .lift_axis import LiftAxisConfig

logging.basicConfig(
    #level=logging.INFO,  
    format="[%(filename)s:%(lineno)d] %(message)s"
)

class AlohaMiniClient(Robot):
    config_class = LeKiwiClientConfig
    name = "alohamini_client"

    def __init__(self, config: LeKiwiClientConfig):
        import zmq

        self._zmq = zmq
        super().__init__(config)
        self.config = config
        self.id = config.id
        self.robot_type = config.type
        
        # Recording State
        self.is_recording = False
        self.recorded_frames = []
        self.recording_path = None

        self.remote_ip = config.remote_ip
        self.port_zmq_cmd = config.port_zmq_cmd
        self.port_zmq_observations = config.port_zmq_observations

        self.teleop_keys = config.teleop_keys

        self.polling_timeout_ms = config.polling_timeout_ms
        self.connect_timeout_s = config.connect_timeout_s

        self.zmq_context = None
        self.zmq_cmd_socket = None
        self.zmq_observation_socket = None

        self.last_frames = {}

        self.last_remote_state = {}

        # Define three speed levels and a current index
        self.speed_levels = [
            {"xy": 0.15, "theta": 45},  # slow
            {"xy": 0.2, "theta": 60},  # medium
            {"xy": 0.25, "theta": 75},  # fast
        ]
        self.speed_index = 0  # Start at slow

        self._is_connected = False
        self.logs = {}

    @cached_property
    def _state_ft(self) -> dict[str, type]:
        return dict.fromkeys(
            (
                "arm_left_shoulder_pan.pos",
                "arm_left_shoulder_lift.pos",
                "arm_left_elbow_flex.pos",
                "arm_left_wrist_flex.pos",
                #"left_wrist_yaw.pos",
                "arm_left_wrist_roll.pos",
                "arm_left_gripper.pos",
                "arm_right_shoulder_pan.pos",
                "arm_right_shoulder_lift.pos",
                "arm_right_elbow_flex.pos",
                "arm_right_wrist_flex.pos",
                #"right_wrist_yaw.pos",
                "arm_right_wrist_roll.pos",
                "arm_right_gripper.pos",
                "x.vel",
                "y.vel",
                "theta.vel",
                "lift_axis.height_mm",   
                #"lift_axis.vel",         
            ),
            float,
        )

    @cached_property
    def _state_order(self) -> tuple[str, ...]:
        return tuple(self._state_ft.keys())

    @cached_property
    def _cameras_ft(self) -> dict[str, tuple[int, int, int]]:
        return {name: (cfg.height, cfg.width, 3) for name, cfg in self.config.cameras.items()}

    @cached_property
    def observation_features(self) -> dict[str, type | tuple]:
        return {**self._state_ft, **self._cameras_ft}

    @cached_property
    def action_features(self) -> dict[str, type]:
        return self._state_ft

    @property
    def is_connected(self) -> bool:
        return self._is_connected

    @property
    def is_calibrated(self) -> bool:
        pass

    def connect(self) -> None:
        """Establishes ZMQ sockets with the remote mobile robot"""

        if self._is_connected:
            raise DeviceAlreadyConnectedError(
                "AlohaMini Daemon is already connected. Do not run `robot.connect()` twice."
            )

        zmq = self._zmq
        self.zmq_context = zmq.Context()
        self.zmq_cmd_socket = self.zmq_context.socket(zmq.PUSH)
        zmq_cmd_locator = f"tcp://{self.remote_ip}:{self.port_zmq_cmd}"
        self.zmq_cmd_socket.connect(zmq_cmd_locator)
        self.zmq_cmd_socket.setsockopt(zmq.CONFLATE, 1)

        self.zmq_observation_socket = self.zmq_context.socket(zmq.PULL)
        zmq_observations_locator = f"tcp://{self.remote_ip}:{self.port_zmq_observations}"
        self.zmq_observation_socket.connect(zmq_observations_locator)
        self.zmq_observation_socket.setsockopt(zmq.CONFLATE, 1)

        poller = zmq.Poller()
        poller.register(self.zmq_observation_socket, zmq.POLLIN)
        socks = dict(poller.poll(self.connect_timeout_s * 1000))
        if self.zmq_observation_socket not in socks or socks[self.zmq_observation_socket] != zmq.POLLIN:
            raise DeviceNotConnectedError("Timeout waiting for AlohaMini Host to connect expired.")

        self._is_connected = True

    def calibrate(self) -> None:
        pass

    def _poll_and_get_latest_message(self) -> str | None:
        """Polls the ZMQ socket for a limited time and returns the latest message string."""
        zmq = self._zmq
        poller = zmq.Poller()
        poller.register(self.zmq_observation_socket, zmq.POLLIN)

        try:
            socks = dict(poller.poll(self.polling_timeout_ms))
        except zmq.ZMQError as e:
            logging.error(f"ZMQ polling error: {e}")
            return None

        if self.zmq_observation_socket not in socks:
            logging.info("No new data available within timeout.")
            return None

        last_msg = None
        while True:
            try:
                msg = self.zmq_observation_socket.recv_string(zmq.NOBLOCK)
                last_msg = msg
            except zmq.Again:
                break

        if last_msg is None:
            logging.info("Poller indicated data, but failed to retrieve message.")

        return last_msg

    def _parse_observation_json(self, obs_string: str) -> dict[str, Any] | None:
        """Parses the JSON observation string."""
        try:
            return json.loads(obs_string)
        except json.JSONDecodeError as e:
            logging.error(f"Error decoding JSON observation: {e}")
            return None

    def _decode_image_from_b64(self, image_b64: str) -> np.ndarray | None:
        """Decodes a base64 encoded image string to an OpenCV image."""
        if not image_b64:
            return None
        try:
            jpg_data = base64.b64decode(image_b64)
            np_arr = np.frombuffer(jpg_data, dtype=np.uint8)
            frame = cv2.imdecode(np_arr, cv2.IMREAD_COLOR)
            if frame is None:
                logging.warning("cv2.imdecode returned None for an image.")
            return frame
        except (TypeError, ValueError) as e:
            logging.error(f"Error decoding base64 image data: {e}")
            return None

    def _remote_state_from_obs(
        self, observation: dict[str, Any]
    ) -> tuple[dict[str, np.ndarray], dict[str, Any]]:
        """Extracts frames, and state from the parsed observation."""

        flat_state = {key: observation.get(key, 0.0) for key in self._state_order}

        state_vec = np.array([flat_state[key] for key in self._state_order], dtype=np.float32)

        obs_dict: dict[str, Any] = {**flat_state, "observation.state": state_vec}
        #lineno = frame.f_lineno
        #print(f"[{filename}:{lineno}] obs_dict:{obs_dict}")
        #print(f"[{filename}:{frame.f_lineno}] obs_dict:{obs_dict}")
        
        #logging.warning("obs_dict: %s", obs_dict)

        # Decode images
        current_frames: dict[str, np.ndarray] = {}
        for cam_name, image_b64 in observation.items():
            if cam_name not in self._cameras_ft:
                continue
            frame = self._decode_image_from_b64(image_b64)
            if frame is not None:
                current_frames[cam_name] = frame

        return current_frames, obs_dict

    def _get_data(self) -> tuple[dict[str, np.ndarray], dict[str, Any], dict[str, Any]]:
        """
        Polls the video socket for the latest observation data.

        Attempts to retrieve and decode the latest message within a short timeout.
        If successful, updates and returns the new frames, speed, and arm state.
        If no new data arrives or decoding fails, returns the last known values.
        """

        # 1. Get the latest message string from the socket
        latest_message_str = self._poll_and_get_latest_message()

        # 2. If no message, return cached data
        if latest_message_str is None:
            return self.last_frames, self.last_remote_state

        # 3. Parse the JSON message
        observation = self._parse_observation_json(latest_message_str)

        

        # 4. If JSON parsing failed, return cached data
        if observation is None:
            return self.last_frames, self.last_remote_state

        # 5. Process the valid observation data
        try:
            new_frames, new_state = self._remote_state_from_obs(observation)
        except Exception as e:
            logging.error(f"Error processing observation data, serving last observation: {e}")
            return self.last_frames, self.last_remote_state

        self.last_frames = new_frames
        self.last_remote_state = new_state

        return new_frames, new_state

    def get_observation(self) -> dict[str, Any]:
        """
        Capture observations from the remote robot: current follower arm positions,
        present wheel speeds (converted to body-frame velocities: x, y, theta),
        and a camera frame. Receives over ZMQ, translate to body-frame vel
        """
        if not self._is_connected:
            raise DeviceNotConnectedError("AlohaMiniClient is not connected. You need to run `robot.connect()`.")

        frames, obs_dict = self._get_data()

        # Loop over each configured camera
        for cam_name, frame in frames.items():
            if frame is None:
                logging.warning("Frame is None")
                frame = np.zeros((640, 480, 3), dtype=np.uint8)
            obs_dict[cam_name] = frame


        return obs_dict

    def _from_keyboard_to_base_action(self, pressed_keys: np.ndarray):
        # Speed control
        if self.teleop_keys["speed_up"] in pressed_keys:
            self.speed_index = min(self.speed_index + 1, 2)
        if self.teleop_keys["speed_down"] in pressed_keys:
            self.speed_index = max(self.speed_index - 1, 0)
        speed_setting = self.speed_levels[self.speed_index]
        xy_speed = speed_setting["xy"]  # e.g. 0.1, 0.25, or 0.4
        theta_speed = speed_setting["theta"]  # e.g. 30, 60, or 90

        x_cmd = 0.0  # m/s forward/backward
        y_cmd = 0.0  # m/s lateral
        theta_cmd = 0.0  # deg/s rotation

        if self.teleop_keys["forward"] in pressed_keys:
            x_cmd += xy_speed
        if self.teleop_keys["backward"] in pressed_keys:
            x_cmd -= xy_speed
        if self.teleop_keys["left"] in pressed_keys:
            y_cmd += xy_speed
        if self.teleop_keys["right"] in pressed_keys:
            y_cmd -= xy_speed
        if self.teleop_keys["rotate_left"] in pressed_keys:
            theta_cmd += theta_speed
        if self.teleop_keys["rotate_right"] in pressed_keys:
            theta_cmd -= theta_speed


        return {
            "x.vel": x_cmd,
            "y.vel": y_cmd,
            "theta.vel": theta_cmd,
        }
    
    # lift_axis.vel
    # def _from_keyboard_to_lift_action(self, pressed_keys: np.ndarray):
    #     LIFT_VEL = 1000  # 觉得慢/快就改
    #     up_pressed = self.teleop_keys.get("lift_up", "u") in pressed_keys
    #     dn_pressed = self.teleop_keys.get("lift_down", "j") in pressed_keys

    #     if up_pressed and not dn_pressed:
    #         v = +LIFT_VEL
    #     elif dn_pressed and not up_pressed:
    #         v = -LIFT_VEL
    #     else:
    #         v = 0.0
    #     return {"lift_axis.vel": int(v)}
    

    # lift_axis.height_mm
    def _from_keyboard_to_lift_action(self, pressed_keys: np.ndarray):
        up_pressed = self.teleop_keys.get("lift_up", "u") in pressed_keys
        dn_pressed = self.teleop_keys.get("lift_down", "j") in pressed_keys

        # Read the last height (mm) reported by the Host
        h_now = float(self.last_remote_state.get("lift_axis.height_mm", 0.0))
        #print(f"h_now:{h_now}")

        if not (up_pressed or dn_pressed):
        # If neither 'u' nor 'j' is pressed, reuse the previous value to avoid empty input
            #return {"lift_axis.height_mm": h_now}
            return {"lift_axis.height_mm": h_now}

        # Increment on each key press
        if up_pressed and not dn_pressed:
            h_target = h_now + LiftAxisConfig.step_mm
        elif dn_pressed and not up_pressed:
            h_target = h_now - LiftAxisConfig.step_mm
        else:
            h_target = h_now
        #print(f"h_target:{h_target}")

        # Send "target height (mm)" directly
        return {"lift_axis.height_mm": h_target}




    def configure(self):
        pass

    def send_action(self, action: dict[str, Any]) -> dict[str, Any]:
        """Command AlohaMini to move to a target joint configuration. Translates to motor space + sends over ZMQ

        Args:
            action (np.ndarray): array containing the goal positions for the motors.

        Raises:
            RobotDeviceNotConnectedError: if robot is not connected.

        Returns:
            np.ndarray: the action sent to the motors, potentially clipped.
        """
        if not self._is_connected:
            raise DeviceNotConnectedError(
                "ManipulatorRobot is not connected. You need to run `robot.connect()`."
            )

        self.zmq_cmd_socket.send_string(json.dumps(action))  # action is in motor space

        # TODO(Steven): Remove the np conversion when it is possible to record a non-numpy array value
        actions = np.array([action.get(k, 0.0) for k in self._state_order], dtype=np.float32)

        action_sent = {key: actions[i] for i, key in enumerate(self._state_order)}
        action_sent["action"] = actions
        
        # Capture for recording if active
        if self.is_recording:
            self._capture_frame(action_sent)
            
        return action_sent

    def start_recording(self, path: str):
        """Start recording episodes to the specified path."""
        self.recording_path = path
        self.recorded_frames = []
        self.is_recording = True
        logging.info(f"Started recording to {path}")

    def stop_recording(self):
        """Stop recording and save data."""
        self.is_recording = False
        if self.recorded_frames and self.recording_path:
            # Save as a simple pickle or processed format
            # In a real LeRobot integration, this would use the Dataset writer
            try:
                import pickle
                os.makedirs(os.path.dirname(self.recording_path), exist_ok=True)
                with open(self.recording_path, 'wb') as f:
                    pickle.dump(self.recorded_frames, f)
                logging.info(f"Saved {len(self.recorded_frames)} frames to {self.recording_path}")
            except Exception as e:
                logging.error(f"Failed to save recording: {e}")
        self.recorded_frames = []

    def _capture_frame(self, action: dict):
        """Capture current state and action for recording."""
        if not self.is_recording:
            return
        
        # Combine last observation with the action that was just sent
        frame_data = {
            "timestamp": time.time(),
            "observation": self.last_remote_state,
            "action": action
        }
        # Add images if available (Note: storing raw images in memory list can be heavy)
        frame_data["images"] = self.last_frames
        
        self.recorded_frames.append(frame_data)

    def disconnect(self):
        """Cleans ZMQ comms"""
        if self.is_recording:
            self.stop_recording()

        if not self._is_connected:
            raise DeviceNotConnectedError(
                "AlohaMini is not connected. You need to run `robot.connect()` before disconnecting."
            )
        self.zmq_observation_socket.close()
        self.zmq_cmd_socket.close()
        self.zmq_context.term()
        self._is_connected = False
