Utilitron-Robotics/johnny5/software/src/johnny5/base.py

import logging
import time
from typing import Tuple

# Placeholder for specific motor driver (e.g., Roboclaw, ODrive, or simple Serial)
# Assuming a generic serial-based motor controller for now

class DifferentialDriveBase:
    """
    Driver for Johnny 5's Differential Drive Base (Rubber Tires).
    """
    def __init__(self, port: str = "/dev/ttyUSB0", baudrate: int = 115200):
        self.port = port
        self.baudrate = baudrate
        self.is_connected = False
        self.wheel_separation = 0.35 # Meters (approx)
        self.wheel_radius = 0.075    # Meters (approx)
        
        logging.info(f"Initializing Differential Drive Base on {port}")

    def connect(self):
        """Connect to the motor controller."""
        try:
            # import serial
            # self.serial = serial.Serial(self.port, self.baudrate, timeout=1)
            self.is_connected = True
            logging.info("Differential Drive Base Connected")
        except Exception as e:
            logging.error(f"Failed to connect to base: {e}")
            self.is_connected = False

    def drive(self, linear_x: float, angular_z: float):
        """
        Drive the robot using Twist commands.
        
        Args:
            linear_x: Forward velocity (m/s)
            angular_z: Rotational velocity (rad/s)
        """
        if not self.is_connected:
            return

        # Differential Drive Kinematics
        left_vel = linear_x - (angular_z * self.wheel_separation / 2)
        right_vel = linear_x + (angular_z * self.wheel_separation / 2)
        
        # Convert m/s to Motor Commands (Placeholder)
        # self.send_motor_command(left_vel, right_vel)
        # logging.debug(f"Base Drive: L={left_vel:.2f}, R={right_vel:.2f}")

    def stop(self):
        """Stop all motion."""
        self.drive(0, 0)

    def disconnect(self):
        """Stop motors and close connection."""
        self.stop()
        self.is_connected = False
        logging.info("Differential Drive Base Disconnected")
