Utilitron-Robotics/johnny5/(commit log)

2025-11-22 Initial commit: Johnny 5 Autonomous Platform
    [D_Base_SO101_Lekiwi.stl, D_Base_motor_holder_SO101.stl, D_Motor_holder_SO101_Base.stl, D_Motor_holder_SO101_Wrist.stl, D_Rotation_Pitch_SO101.stl, D_Seeedstudio_Mounting_Plate_SO101.stl, D_Under_arm_SO101.stl, D_Upper_arm_SO101.stl]
2025-11-22 Implement LeKiwi single-arm upgrade support and documentation
2025-11-22 Add ROS 2 wrapper package with full arm and base control
2025-11-23 Johnny5 is alive... updated README with CAD files while printing new robot
